emredogan7/METU-EE-2017-2018-Capstone-Design-Project-Repository/README.md

# X-Cali
The repository belonging to "X-Cali" EE493 Capstone Design Project

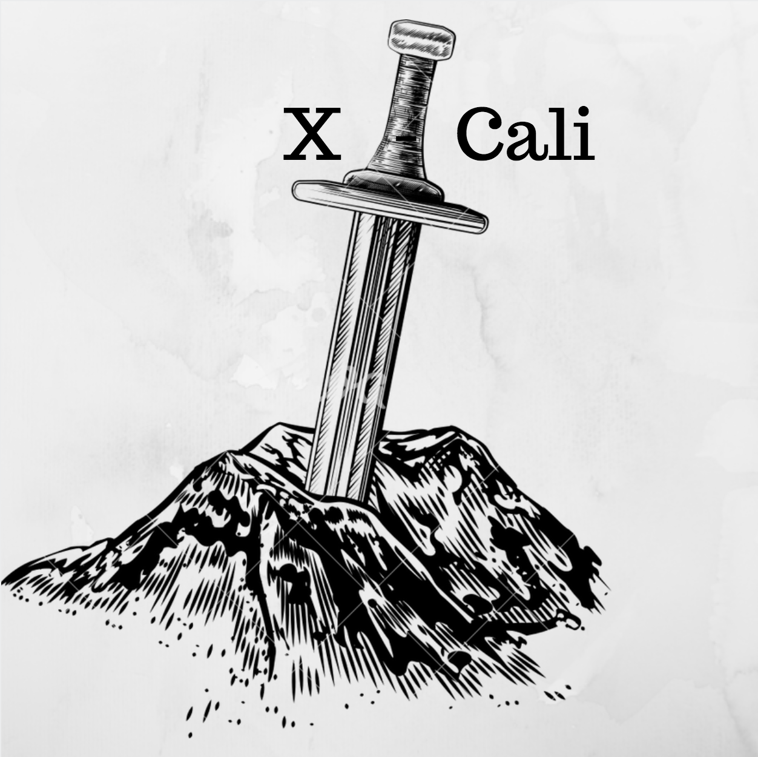
[picture p1: XCali_logo.png]


### Group Members:
- Oytun Akpulat
- Göksenin Hande Bayazıt
- Emre Doğan
- Taha Doğan
- Burak Sezgin
