emredogan7/METU-EE-2017-2018-Capstone-Design-Project-Repository/critical design/burak/Development Schedule.docx

As X-Cali, we were quite successful in our management plan despite the small breakdowns in our previous plan. Since we are halfway through and have little alterations in our plan, we saw fit to update our management plan and so our Gantt Chart. To start with, Communication Subsystem Design contents are updated to show the work to be done, more elaborately. Furthermore, Software Subsystem Design is divided into two branches as Raspberry Pi and Arduino, due to the addition of the Arduino. And their contents are updated to fit the branches, as well. Integration of Subsystems part was affected from this change and, Raspberry Pi and Arduino implementation processes is added. The rest of the management plans is kept as it used to be.

Aforementioned Future plans of X-Cali can be seen in Figure BURAYAFİGUREYAZILACAK.

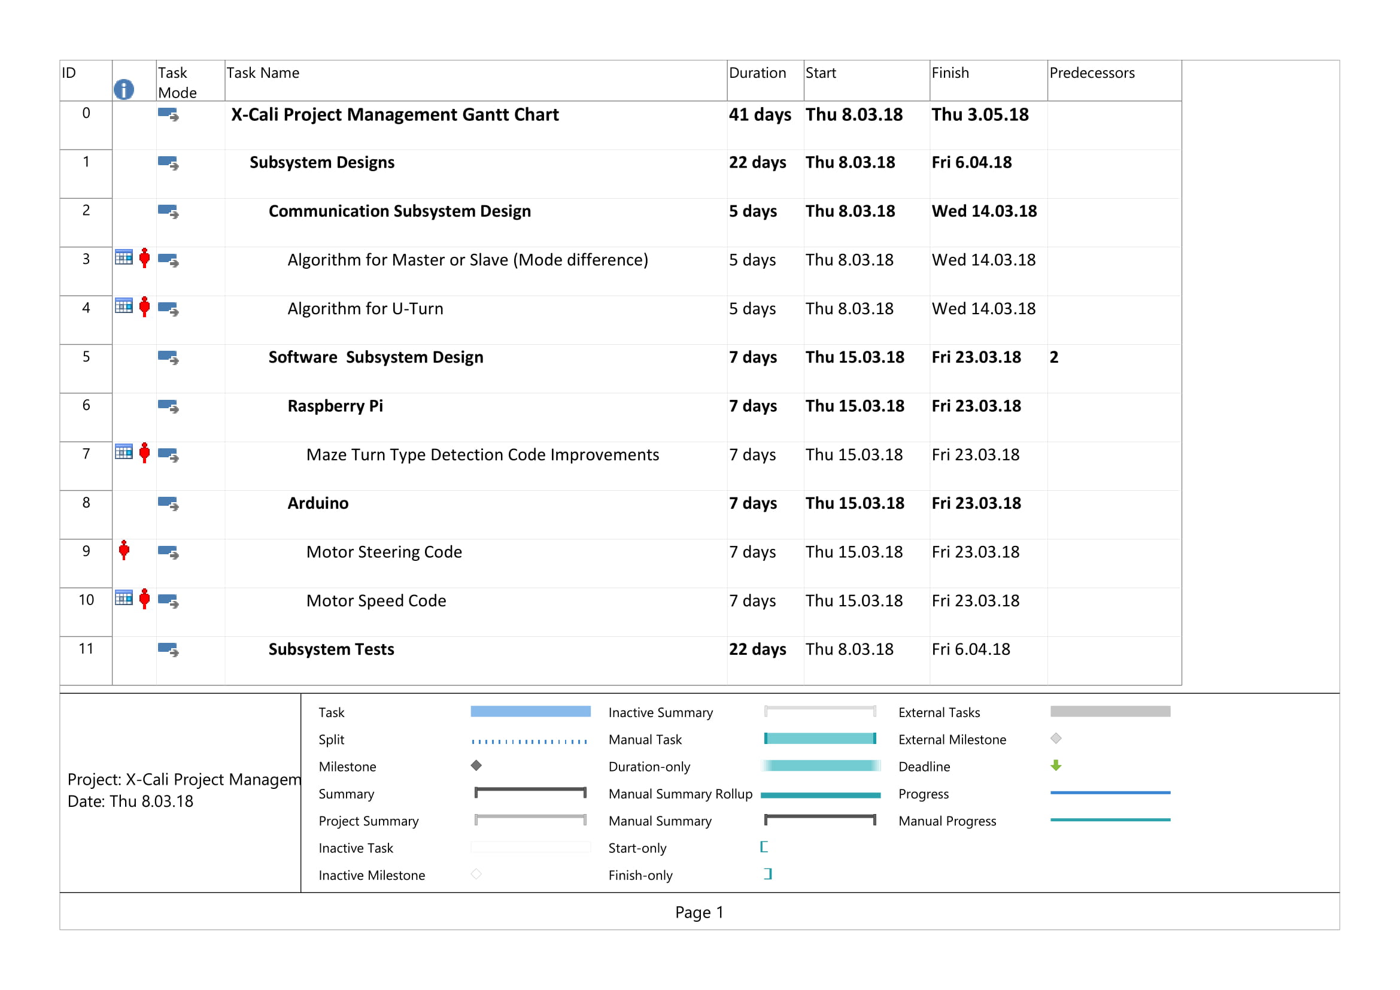
[picture p61: figure]
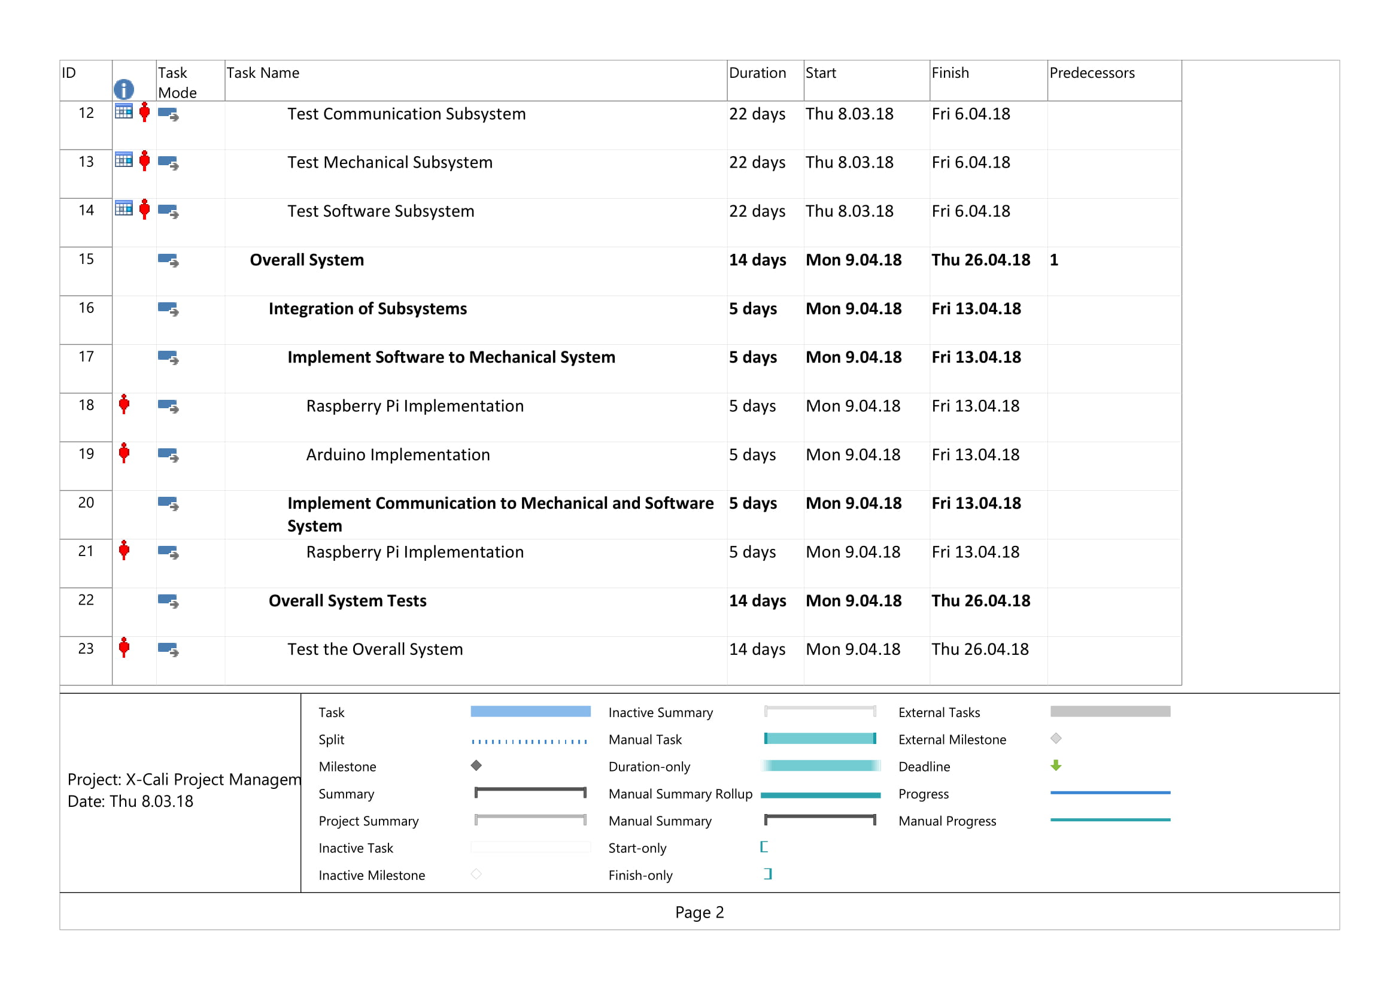
[picture p62: figure]
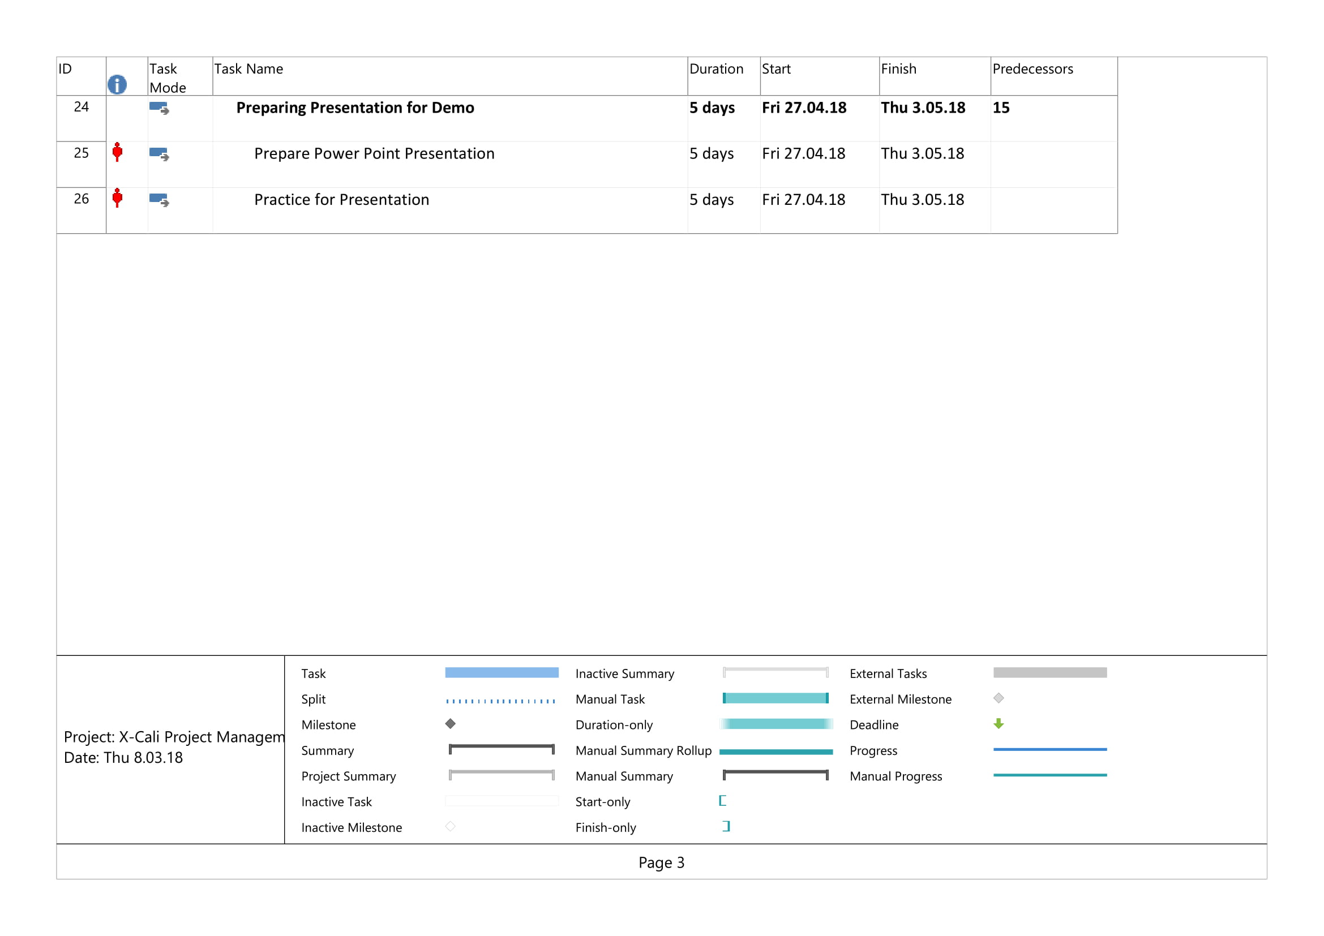
[picture p63: figure]
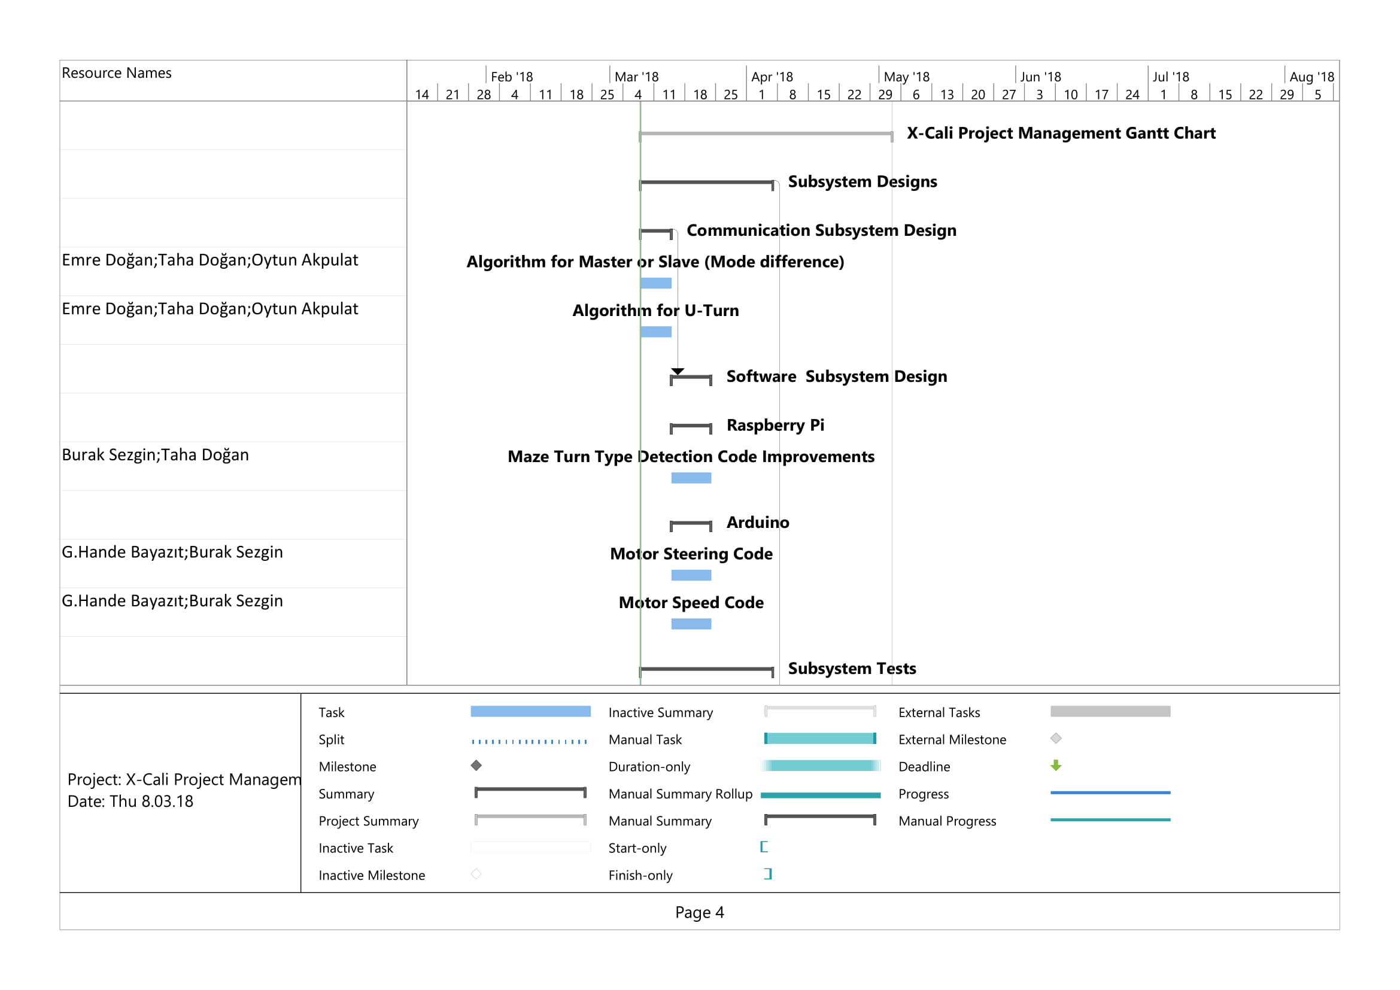
[picture p64: figure]
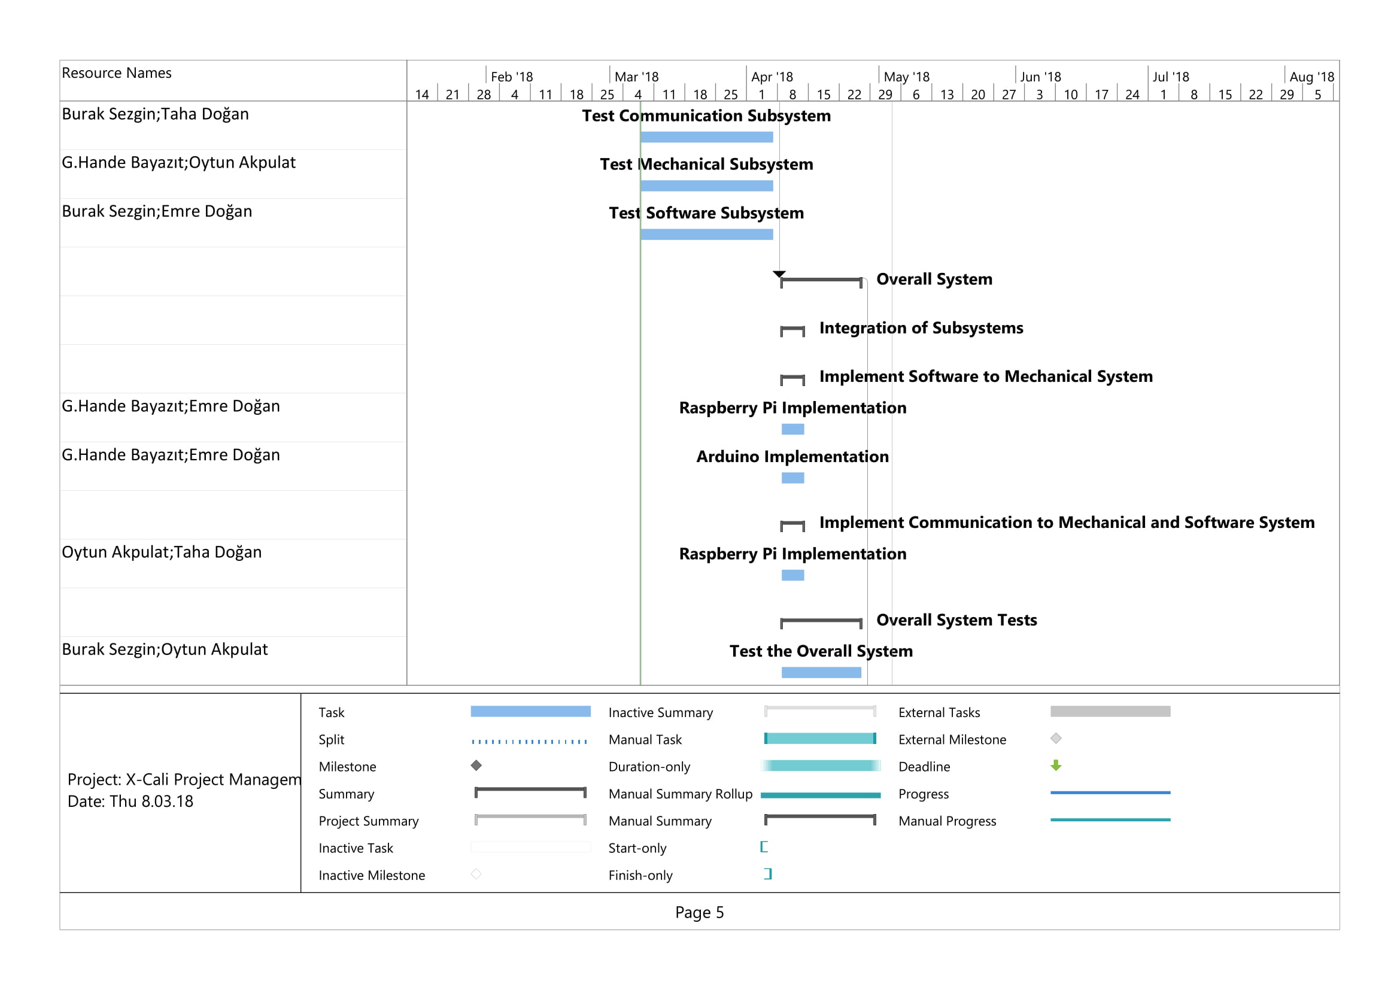
[picture p65: figure]
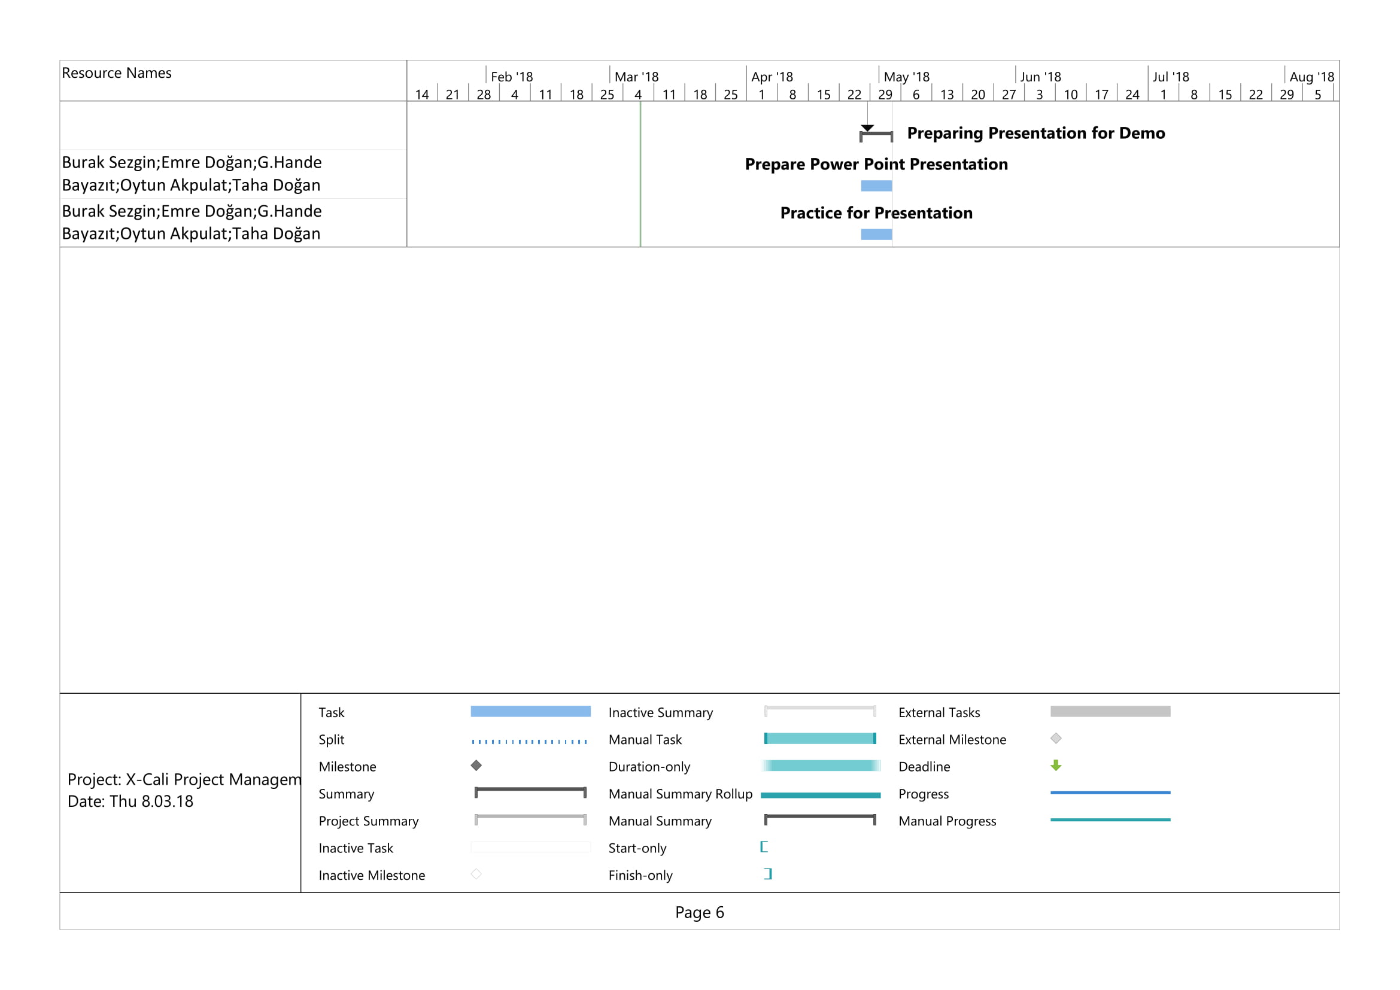
[picture p66: figure]
