emredogan7/METU-EE-2017-2018-Capstone-Design-Project-Repository/critical design/BİRLEŞMİŞİ/CDRR_X-Cali.docx

X-CALI


Critical Design Review Report

“Design of Robots Collaboratively Carrying a Long Object Through an Open-Top Maze”

Submitted to: Ali Özgür Yılmaz

Date of Submission: March 9, 2018

Company Shareholders

- Oytun Akpulat 2093201 oytun.akpulat@metu.edu.tr
- Göksenin Hande Bayazıt 2093441 hande.bayazit@metu.edu.tr
- Emre Doğan 2093656 dogan.emre@metu.edu.tr
- Taha Doğan 2093672 taha.dogan@metu.edu.tr
- Burak Sezgin 2094456 burak.sezgin@metu.edu.tr

# Introduction

# Design Description

## System Description

## Subsystem Analysis

### Body: plank, şase boyutları, pil

### Detection: kameralar, sensörler, algoritma

### Movement: tekerler motorlar, algoritma

## Component Analysis

### Microcontrollers: RP3, Arduino Uno

### Sensors: Ultrasonic, IR

### Motors:

### Chassis: wooden

### Wheels: material, plastic mad wheel: aluminum

## Requirement Analysis

## Risk Analysis

## Power Consumption Analysis

## Cost Analysis

## Development Schedule

# Modification to Conceptual Design

# Test Procedures and Test Results

# Organization Plan

X-CALI
Software Developement
Power Systems and Efficiency
Finance
Mechanical Design
R&D
Burak SEZGİN
Emre DOĞAN
Taha DOĞAN
Oytun AKPULAT
Göksenin Hande BAYAZIT
Burak SEZGİN
Emre DOĞAN
Taha DOĞAN
Burak Sezgin
Göksenin Hande BAYAZIT
Oytun AKPULAT
Taha DOĞAN
Göksenin Hande BAYAZIT

Figure XXXXXXXXX: Organizational Structure of X-Cali

# Conclusion

# References
