emredogan7/METU-EE-2017-2018-Capstone-Design-Project-Repository/sunum_/Birleştirilmiş.pptx

## X-Cali Group

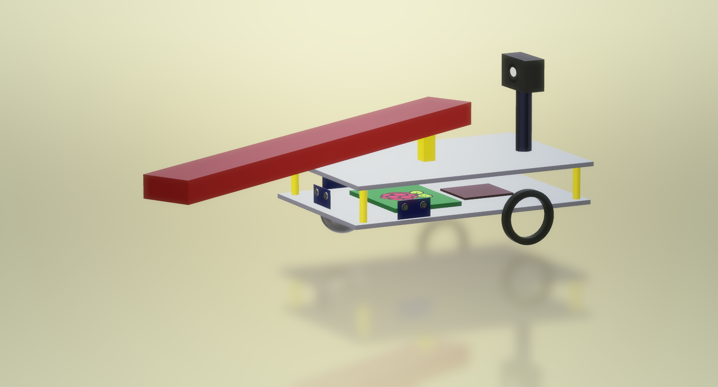
[picture p69: figure]

Burak Sezgin - 2094456
Taha Doğan - 2093672
Göksenin Hande Bayazıt - 2093441
Emre Doğan - 2093656
Oytun Akpulat - 2093201

## Slide 2

## «Robots collaboratively carrying a long object through an open-top maze»

## Outline

- Problem Statement
- Design Process & Solution Approach
- Solutions
  - Main Solution
  - Alternative Solution
- Management
- Test Plans

## Related Specifications

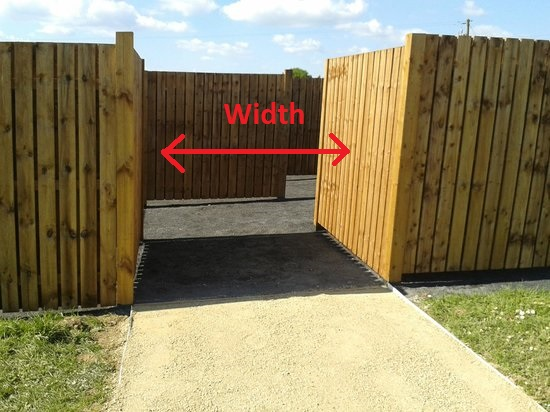
[picture p70: figure]
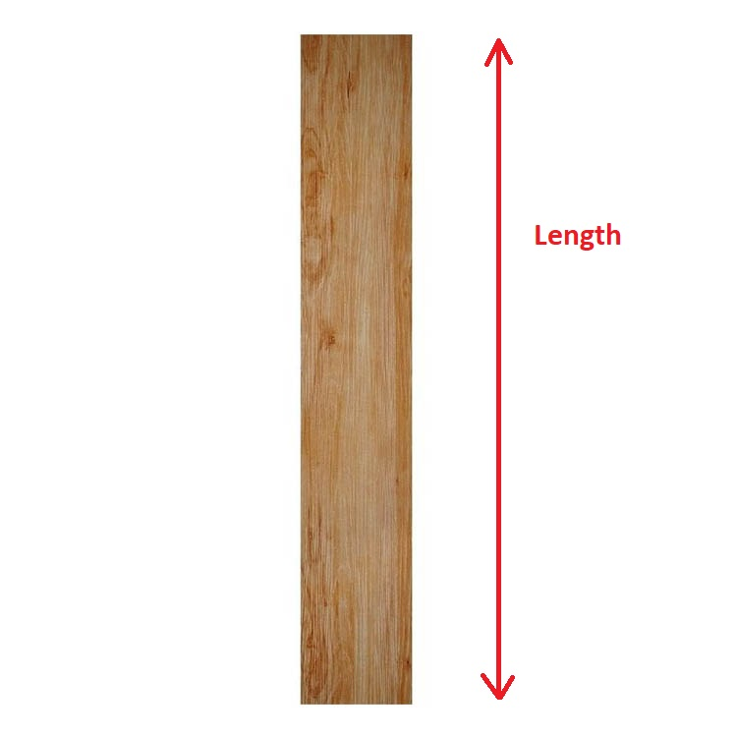
[picture p71: figure]

## Problem Statement

- Cannot make U-Turn at once

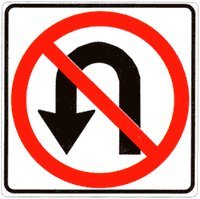
[picture p72: figure]

## Main Problem:

- Determining
- And observing the other robot

## Modes of Operation

- Master
- Slave

## Slide 9

U-Turn Example


(I)

## U-Turn Example


(II)

## U-Turn Example


(III)

## U-Turn Example


(IV)

## U-Turn Example


(V)

## Slide 14

## Design Process & Solution Approach

- Subsystems
  - Movement
    - DC Motors
    - Wheels
  - Sensors
    - Active sensors
    - Passive Sensor: Camera
  - Decision and Control
- Solution Approaches
  - Image Processing
  - Advancing Hall Effect

## Subsystems – Movement

- Motor and Wheel
  - DC motor

Normal wheel
Mad Wheel

## Subsystems – Sensors

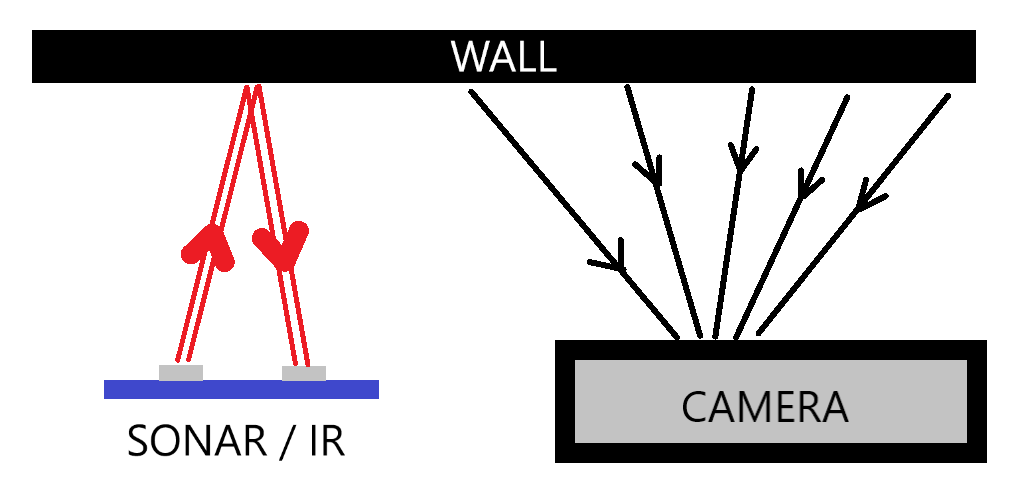
[picture p73: figure]

- Active Sensors: Proximity
  - IR sensors
  - Sonar Sensors
- Passive Sensor: Camera

## Subsystems – Decision and Control

- Microprocessor Select: RaspberryPi3
  - Fast computational skills
  - Wi-Fi Connection
  - ~~4 USB + SDCARD ports~~
  - Versatility on different applications: Image Processing
- DC Motor Driver: L298P
  - Back EMF protection
  - Easy-to-use ports
  - Frequently used, many instructive videos

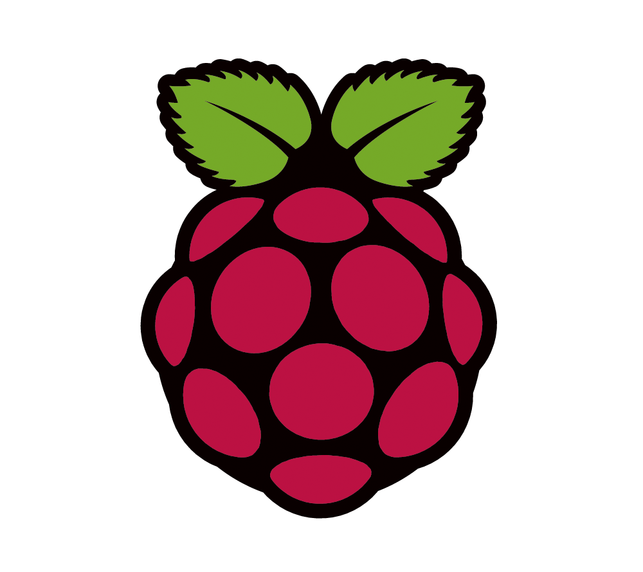
[picture p74: figure]

## Solution Approach – I: Image Processing

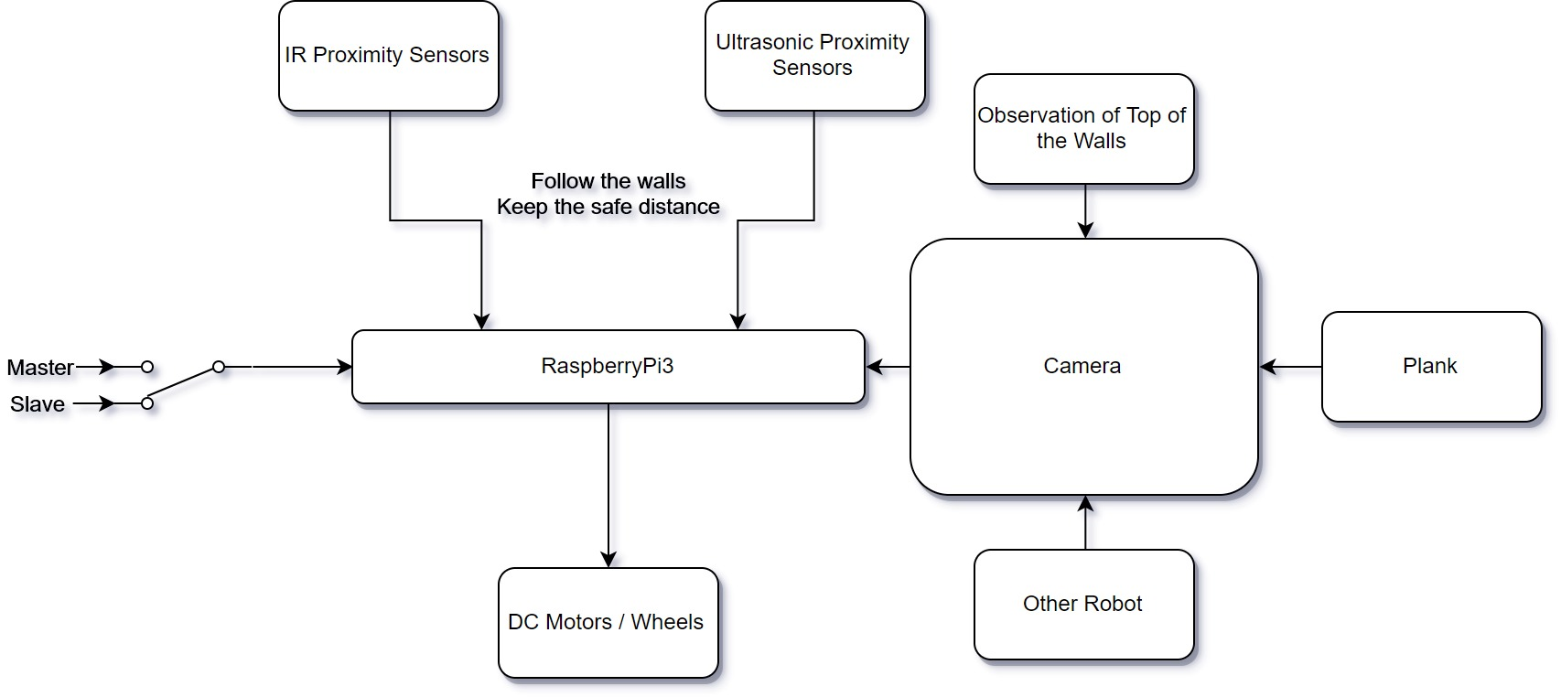
[picture p75: figure]

## Slide 20

- ~~Plank~~ ~~Detection~~
- ~~Binary~~ ~~Masking~~
- ~~Angle~~ ~~Detection~~

## Solution Approach – II: Advancing Hall Effect

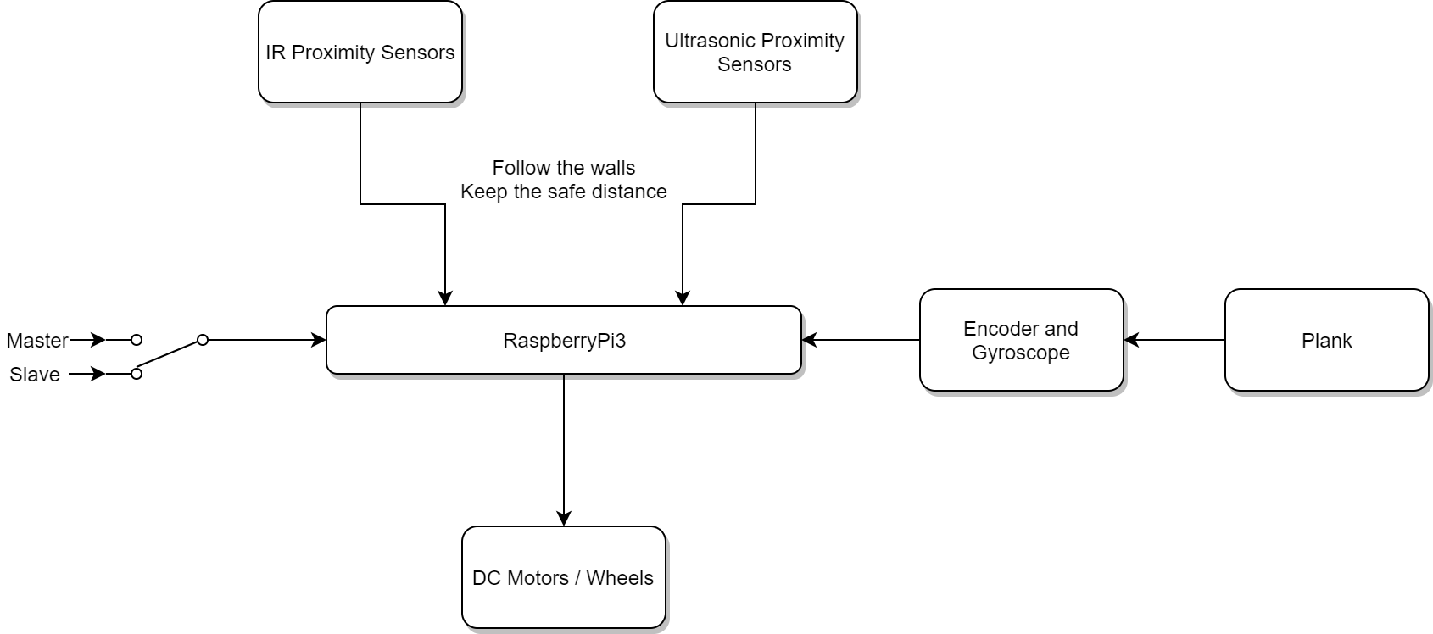
[picture p76: figure]

## Solution Approaches (Technical Details)

- Indirect communication between the robots
- Angle of holding point
  - Image processing based
  - Motion-sensing based

## Solution I: Image Processing

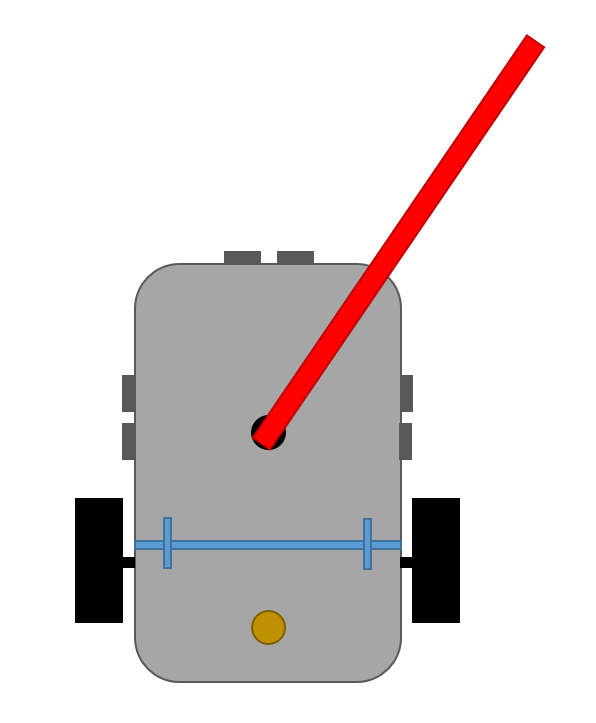
[picture p77: figure]
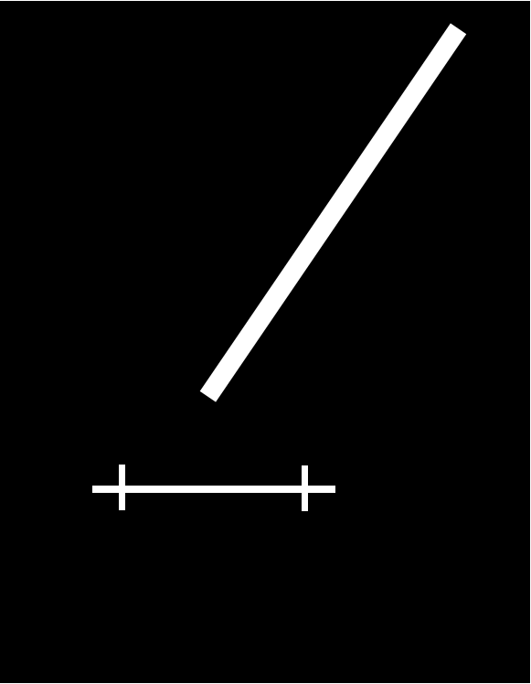
[picture p78: figure]

## Solution I: Image Processing

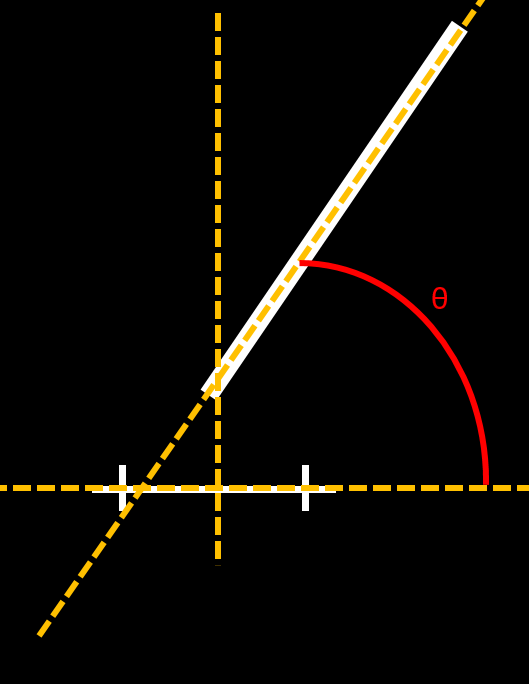
[picture p79: figure]

## Solution I: Image Processing

- Feasible
- Environment dependent
- Reliability problems

## Solution II: Motion-Sensing

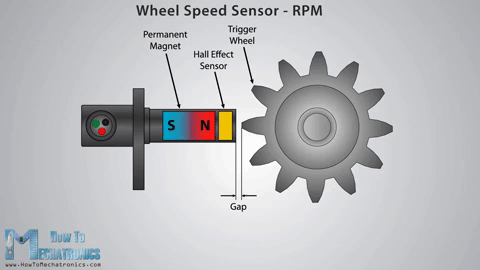
[picture p80: figure]

## Test Plans

- Integration Plans

- Conclusion

## Test Plans

- Proximity Sensor Measurements
- DC Motor Starting Current Test
- Response Time and Turning Angle Test

## Integration Plans

- Test procedure of the software design will be composed of two parts.

- Detailed Documentation of the Software
- Debugging Reports

## Conclusion

- Movement
- Sensors
- Control & Decision

## Movement

DC motor was preferred because it provides two possible speed control methods:

- PWM (Pulse Width Modulation)
- Voltage Control

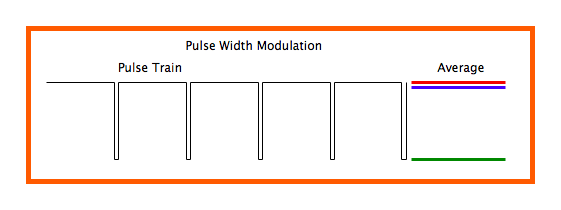
[picture p81: figure]

## Sensors

- Ultrasonic Sensor
- Infrared Sensor
- Camera

## Decision & Control

- Image processing
- Hall Effect Sensor

## Conclusion

- We hope that the X-Cali Company will be a brand new and rapidly rising brand in this market at the end of this project.
