emredogan7/METU-EE-2017-2018-Capstone-Design-Project-Repository/sunum_/Burak.pptx

## X-Cali Group

İsimler falan

## Slide 2

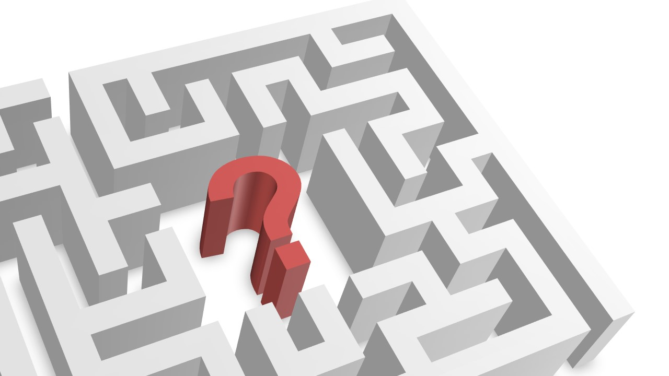
[picture p110: figure]

## Robots collaboratively carrying a long object through an open-top maze

## Outline

- Problem Statement
- Design Process & Solution Approach
- Solutions
  - Main Solution
  - Alternative Solution
- Management
- Test Plans

## Problem Statement

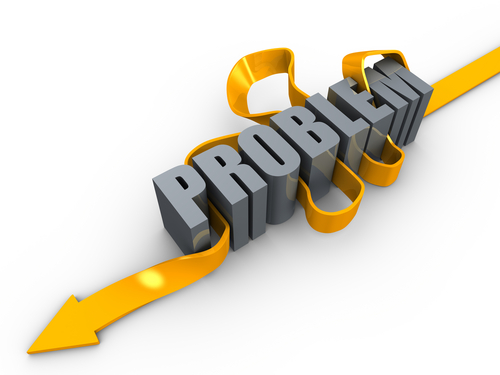
[picture p111: figure]

## Problem Statement

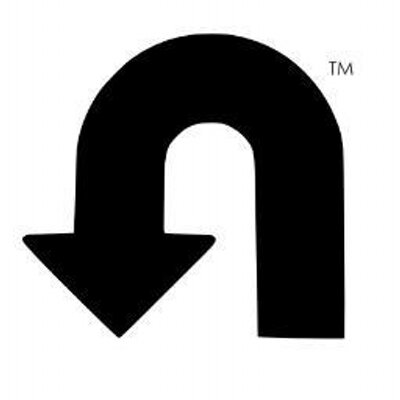
[picture p112: figure]

## Main Problem:

- Determining
- And observing the other robot

## U-Turn Example


(I)

## U-Turn Example


(II)

## U-Turn Example


(III)

## U-Turn Example


(IV)

## U-Turn Example


(V)

## No Communication!

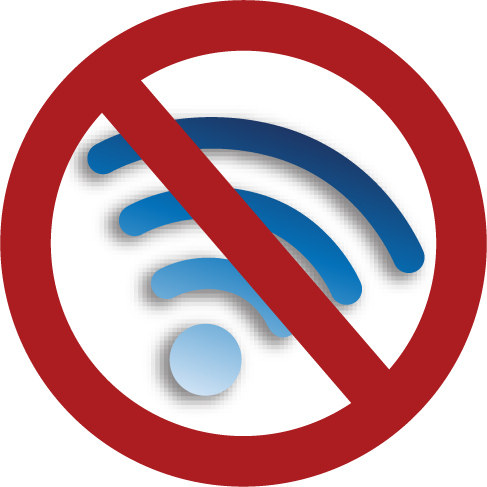
[picture p113: figure]
