emredogan7/METU-EE-2017-2018-Capstone-Design-Project-Repository/sunum_/Hande.pptx

## SOLUTION APPROACH (TECHNICAL DETAILS)

Göksenin Hande Bayazıt

## Solutions

- Image processing based
- Motion-sensing based

## Slide 3


## Slide 4


## Slide 5
