emredogan7/METU-EE-2017-2018-Capstone-Design-Project-Repository/critical design/hande/drawings/2.PNG

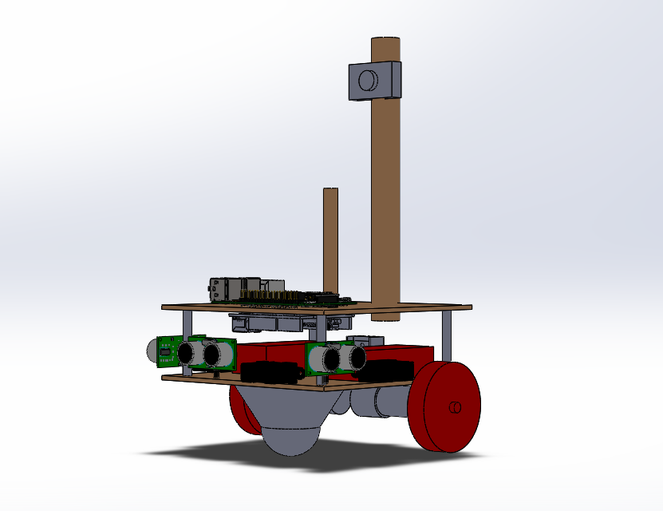
critical design/hande/drawings/2.PNG
