emredogan7/METU-EE-2017-2018-Capstone-Design-Project-Repository/critical design/hande/drawings/4.PNG

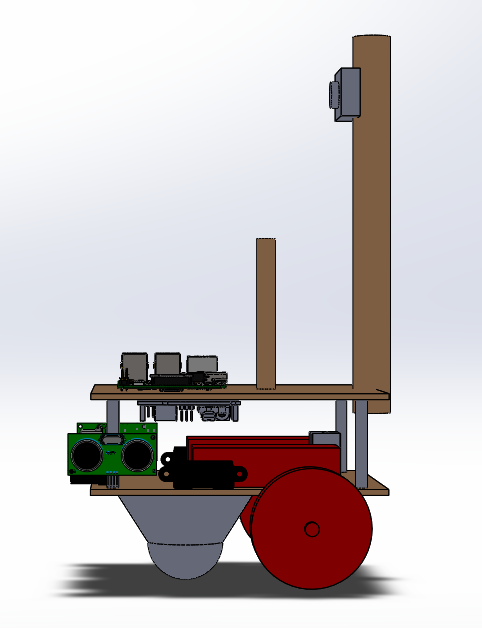
critical design/hande/drawings/4.PNG
