emredogan7/METU-EE-2017-2018-Capstone-Design-Project-Repository/Final Report/Master - Slave FSM.jpg

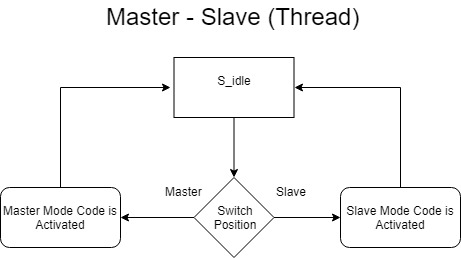
Final Report/Master - Slave FSM.jpg
