emredogan7/METU-EE-2017-2018-Capstone-Design-Project-Repository/Final Report/Maze Turn Type Indentifier FSM.jpg

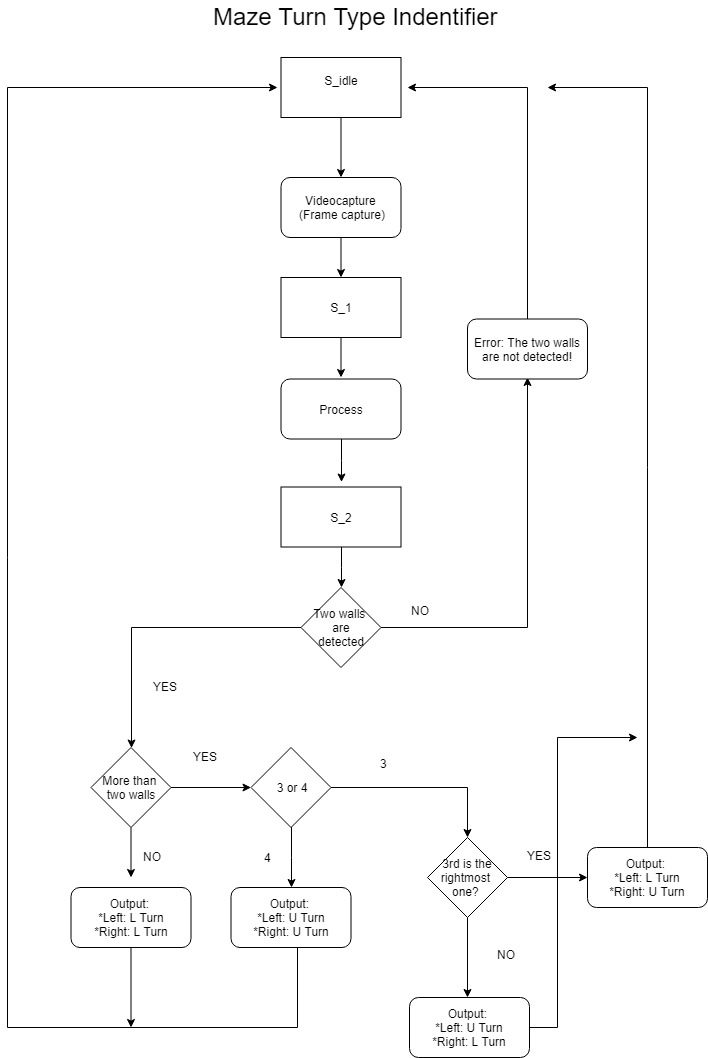
Final Report/Maze Turn Type Indentifier FSM.jpg
