emredogan7/METU-EE-2017-2018-Capstone-Design-Project-Repository/Final Report/WhatsApp Image 2018-04-14 at 11.19.52.jpeg

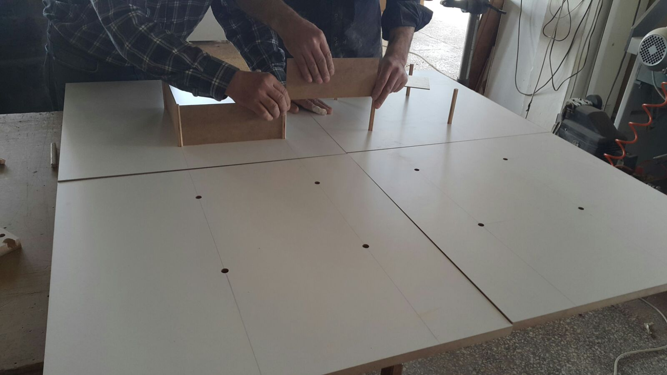
Final Report/WhatsApp Image 2018-04-14 at 11.19.52.jpeg
