emredogan7/METU-EE-2017-2018-Capstone-Design-Project-Repository/images/20180326_095948.jpg

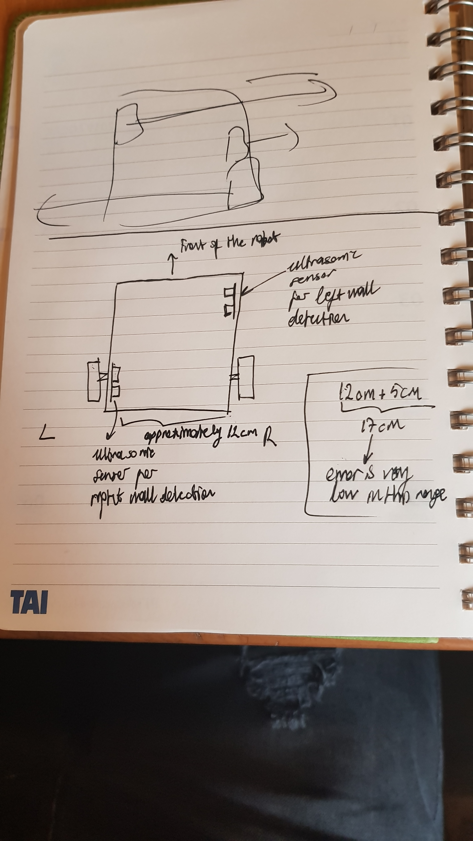
images/20180326_095948.jpg
