emredogan7/METU-EE-2017-2018-Capstone-Design-Project-Repository/images/color_detect.png

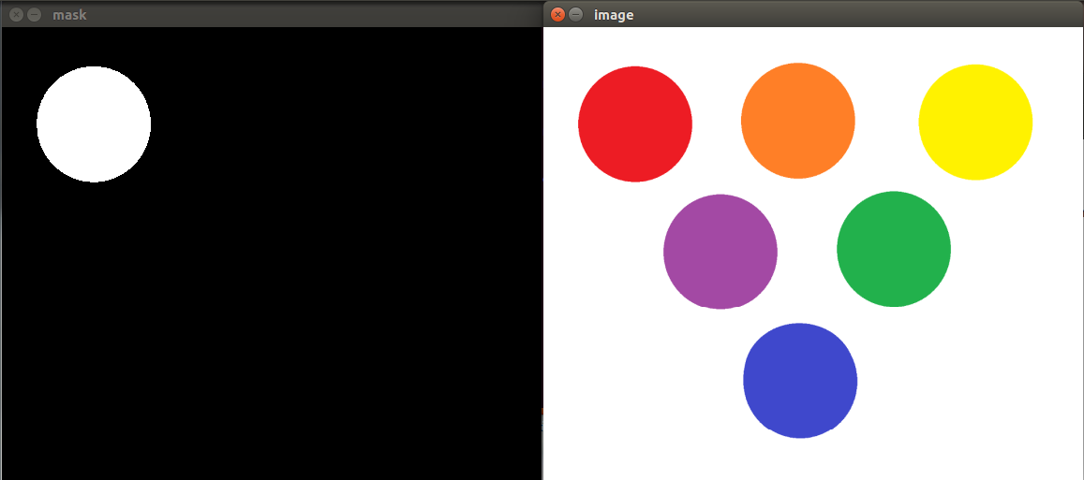
images/color_detect.png
