emredogan7/METU-EE-2017-2018-Capstone-Design-Project-Repository/images/Detecting if other robot stopped/IMG_4360.JPG

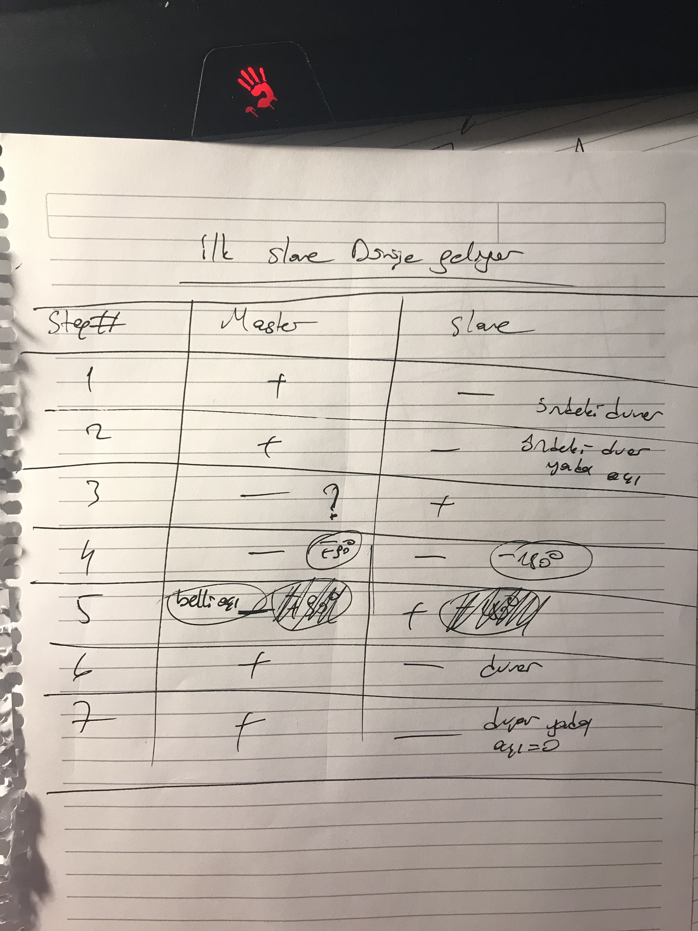
images/Detecting if other robot stopped/IMG_4360.JPG
