emredogan7/METU-EE-2017-2018-Capstone-Design-Project-Repository/images/edge_detection.jpg

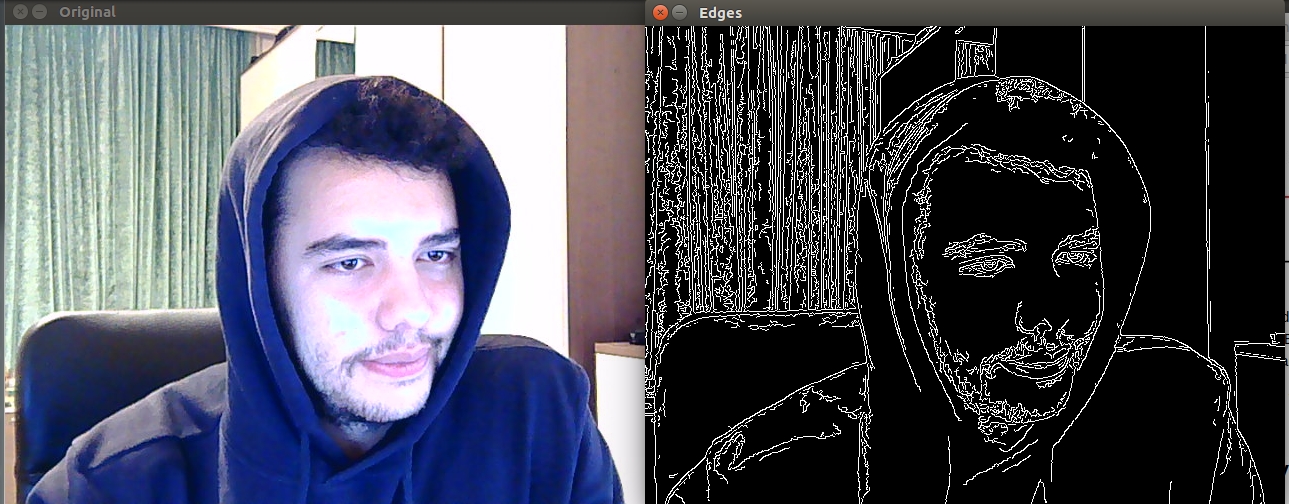
images/edge_detection.jpg
