emredogan7/METU-EE-2017-2018-Capstone-Design-Project-Repository/images/turn_algo/Burak/IMG_4321.JPG

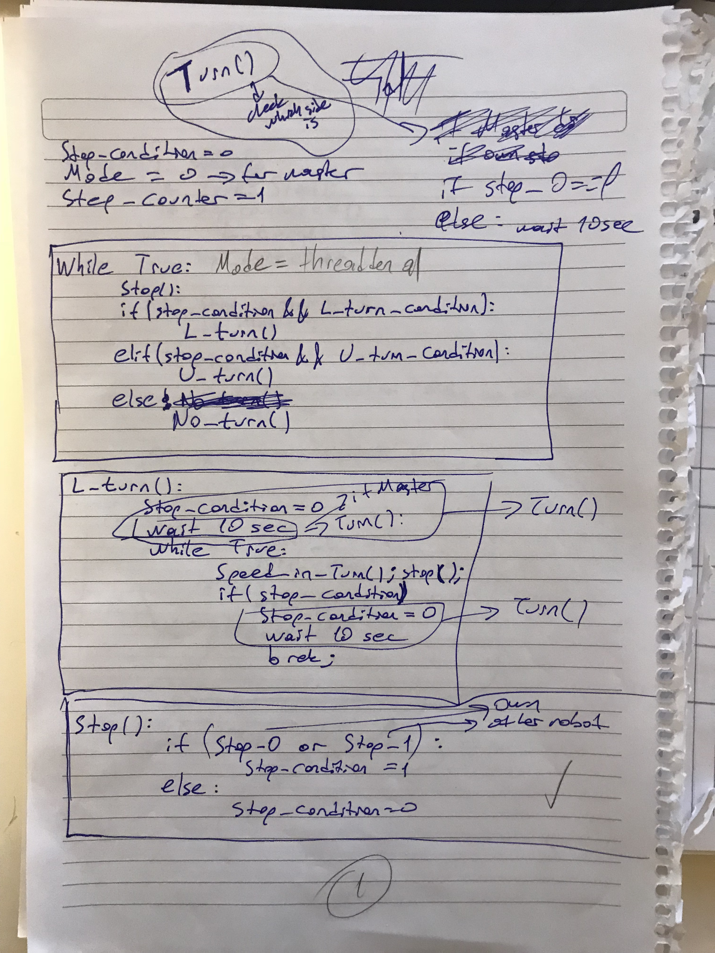
images/turn_algo/Burak/IMG_4321.JPG
