emredogan7/METU-EE-2017-2018-Capstone-Design-Project-Repository/images/turn_algo/Burak/IMG_4323.JPG

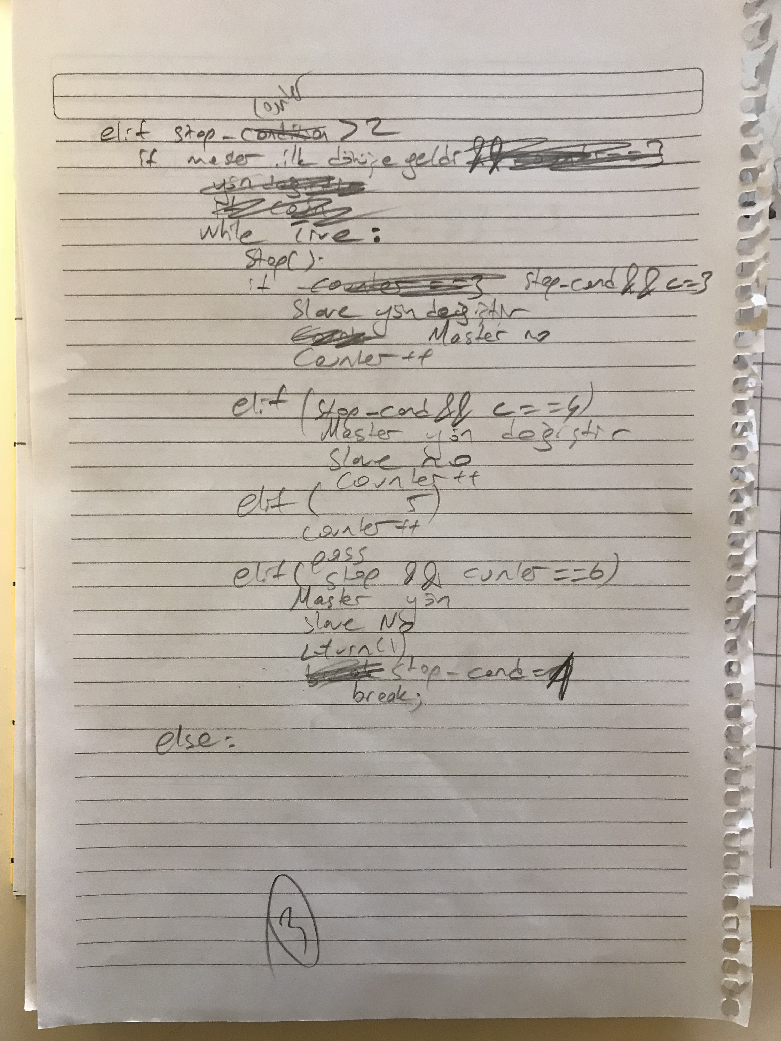
images/turn_algo/Burak/IMG_4323.JPG
