emredogan7/METU-EE-2017-2018-Capstone-Design-Project-Repository/images/turn_algo/Taha - Burak/IMG_4319.JPG

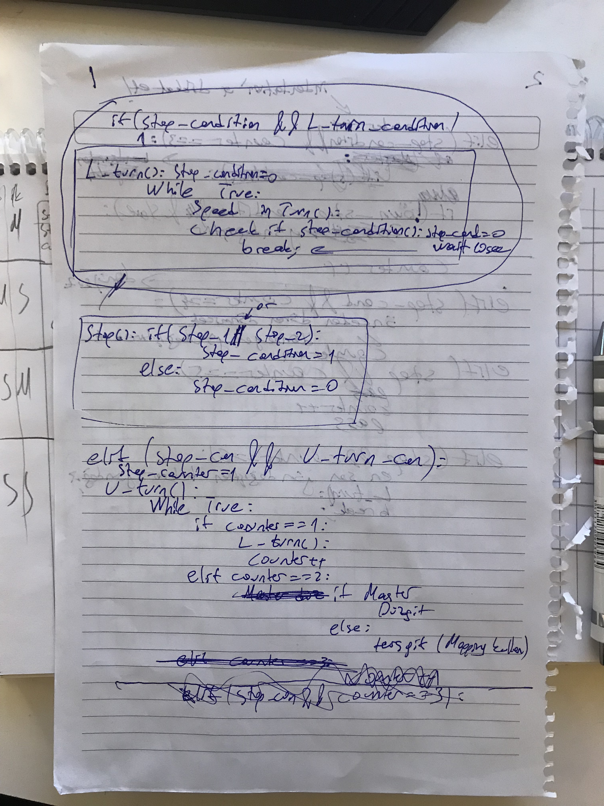
images/turn_algo/Taha - Burak/IMG_4319.JPG
