emredogan7/METU-EE-2017-2018-Capstone-Design-Project-Repository/images/turn_algo_code.JPG

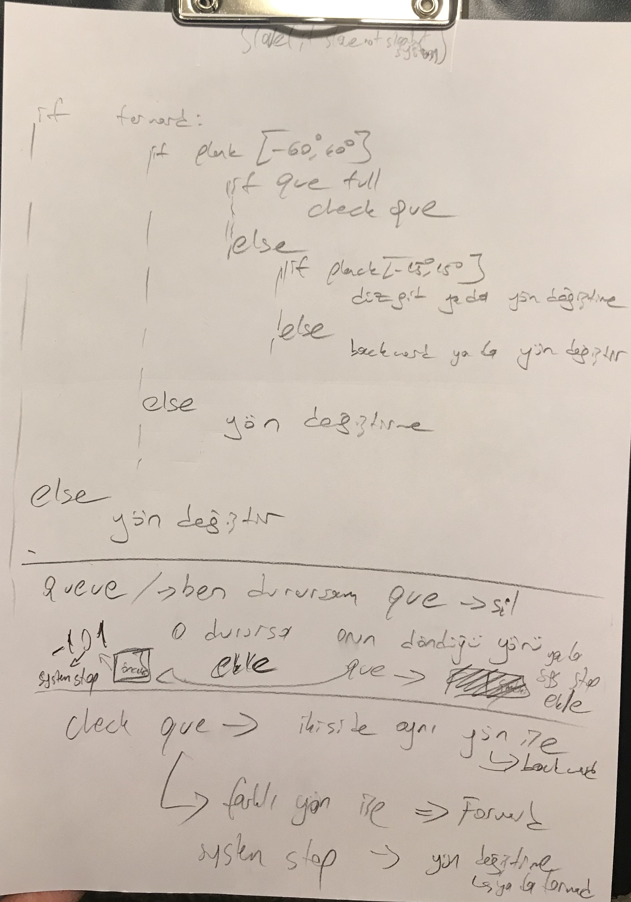
images/turn_algo_code.JPG
