emredogan7/METU-EE-2017-2018-Capstone-Design-Project-Repository/Poster/WhatsApp Image 2018-05-17 at 15.54.25.jpeg

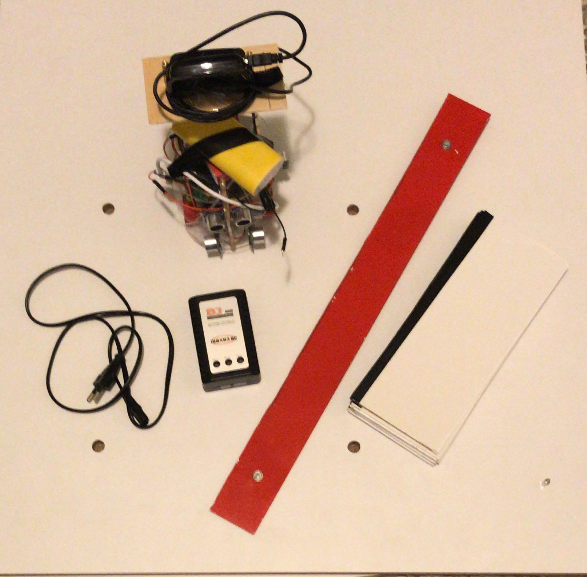
Poster/WhatsApp Image 2018-05-17 at 15.54.25.jpeg
