emredogan7/METU-EE-2017-2018-Capstone-Design-Project-Repository/Presentation/123 (2).PNG

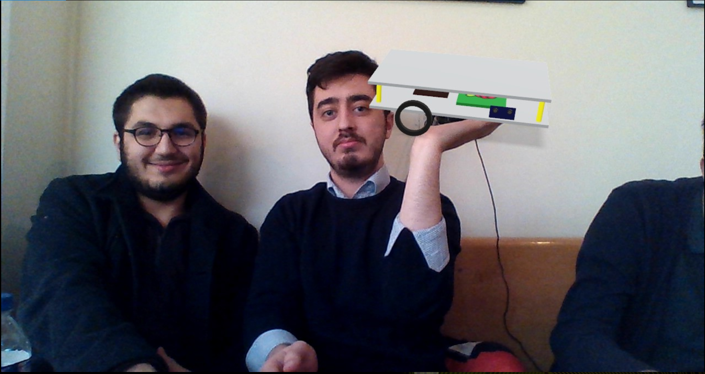
Presentation/123 (2).PNG
