emredogan7/METU-EE-2017-2018-Capstone-Design-Project-Repository/Presentation/EE493 Sunum/active passive.png

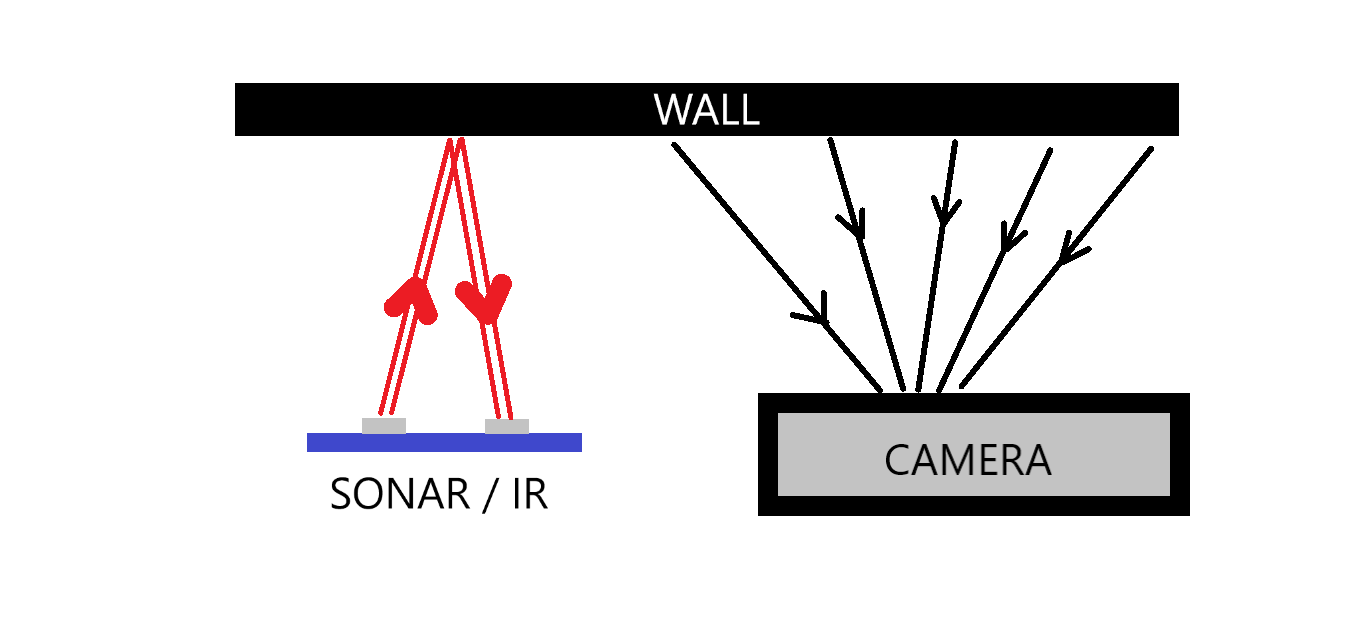
Presentation/EE493 Sunum/active passive.png
