emredogan7/METU-EE-2017-2018-Capstone-Design-Project-Repository/Presentation/ekran görüntüsü.png

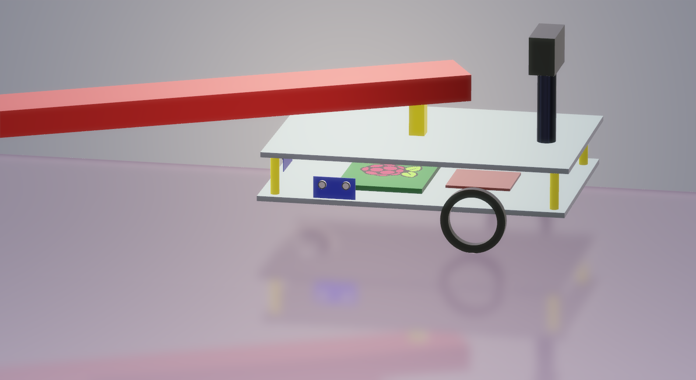
Presentation/ekran görüntüsü.png
