emredogan7/METU-EE-2017-2018-Capstone-Design-Project-Repository/PWM_2_DC.png

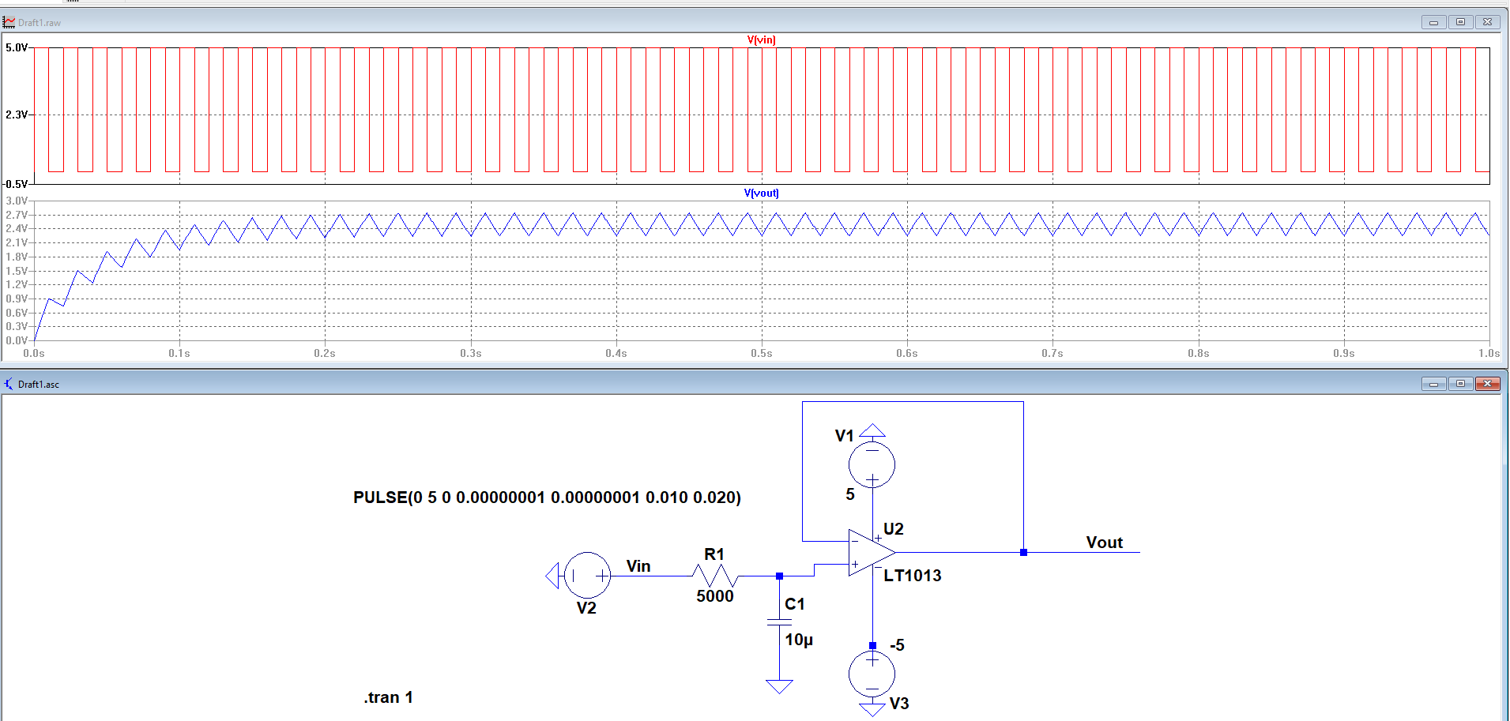
PWM_2_DC.png
