emredogan7/METU-EE-2017-2018-Capstone-Design-Project-Repository/Reference/gpio-descriptions.png

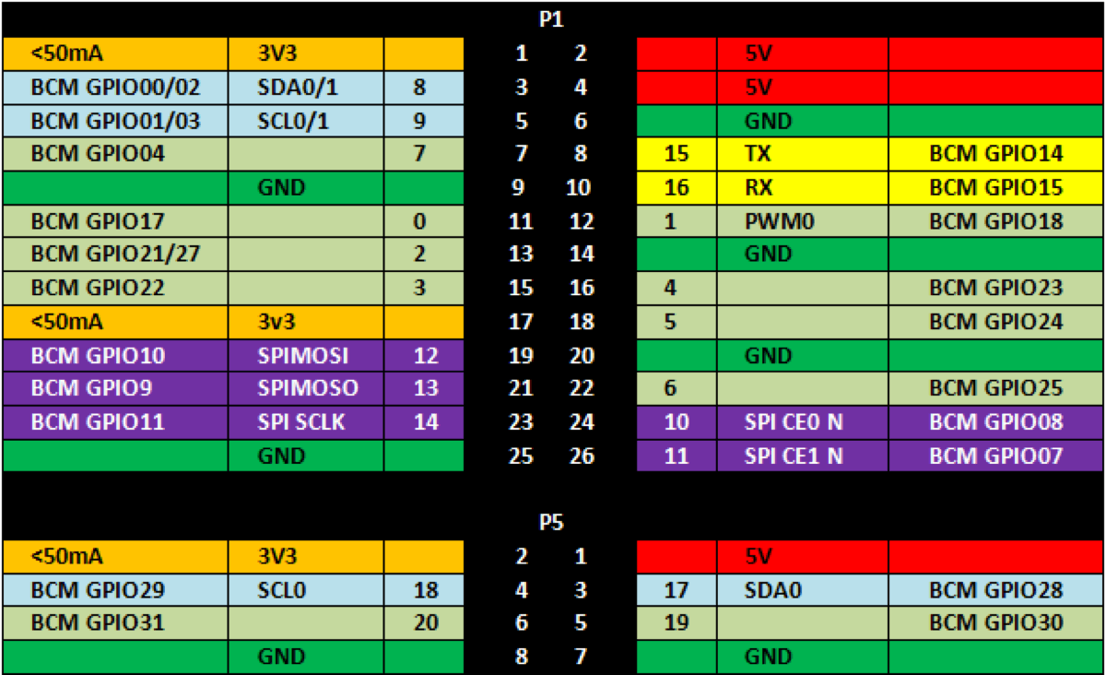
Reference/gpio-descriptions.png
