emredogan7/METU-EE-2017-2018-Capstone-Design-Project-Repository/Reports/Tabble.JPG

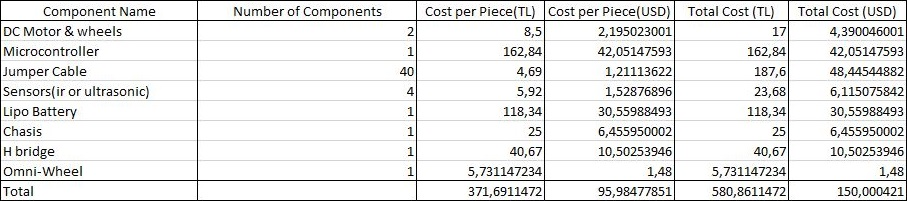
Reports/Tabble.JPG
