emredogan7/METU-EE-2017-2018-Capstone-Design-Project-Repository/Reports/tabble.xlsx

Component Name | Number of Components | Cost per Piece(TL) | Cost per Piece(USD) | Total Cost (TL) | Total Cost (USD)
DC Motor & wheels | 2 | 8.5 | 2.195023001 | 17 | 4.390046001
Microcontroller | 1 | 162.84 | 42.05147593 | 162.84 | 42.05147593
Jumper Cable | 40 | 4.69 | 1.21113622 | 187.6 | 48.44544882
Sensors(ir or ultrasonic) | 4 | 5.92 | 1.52876896 | 23.68 | 6.115075842
Lipo Battery | 1 | 118.34 | 30.55988493 | 118.34 | 30.55988493
Chasis | 1 | 25 | 6.455950002 | 25 | 6.455950002
H bridge | 1 | 40.67 | 10.50253946 | 40.67 | 10.50253946
Omni-Wheel | 1 | 5.731147234 | 1.48 | 5.731147234 | 1.48
Total |  | 371.6911472 | 95.98477851 | 580.8611472 | 150.000421
