emredogan7/METU-EE-2017-2018-Capstone-Design-Project-Repository/Tests/motor-test-word.docx

DC Motor Starting Current Test

by Go¨ksenin Hande Bayazıt & Taha Dog˘an

Dec. 17, 2017

# 1 Test Conditions

- Location: Design Studio
- Date: Dec. 17, 2017
- Ambient Temperature: Room temperature (appx. 23-25◦C)
- Environment: Loud, luminous

# 2 Test Procedure

The aim of this test is to measure the starting current of the DC motor. To achieve this, a microcontroller is programmed as a digital voltmeter (in the scope of EE447 laboratory). With such a setup, the voltage drop on a resistor connected in series to the terminals of the motor can be measured and recorded, which provides the information of armature current of the motor.

However, as the resistance value of the measurement resistor is not negligible compared to the internal resistance of the motor, it causes a significant change in the starting current. For that reason, internal resistance of the DC motor should be determined with full-load test in order to be able to make necessary calculations. (In full-load test, starting current of the DC motor is measured when the shaft speed, hence the back EMF is 0. Therefore, having the terminal voltage and armature current informations, we are able to determine the value of internal resistance.)

# 3 Test Results

## 3.1 Full-Load Test

3.1.1 Specifications:

- Battery Voltage Before Measurement: 8.1 V
- Battery Voltage After Measurement: 8 V
- ω = 0 rad/s, Eb = 0 V

3.1.2 Measurement Results:

1. Ia = 0.60 A
2. Ia = 0.58 A
3. Ia = 0.55 A
4. Ia = 0.56 A
5. Ia = 0.61 A
6. Ia = 0.55 A
7. Ia = 0.55 A
8. Ia = 0.56 A
9. Ia = 0.54 A
10. Ia = 0.55 A

Mean: Ia = 0.57 A

## 3.2 Starting Current

3.2.1 Specifications:

- Measurement Resistor: 10 Ω
- Battery Voltage: 8 V
- Mechanical Load: Tyre moving on low-friction-surface

3.2.2 Measurement Results:

1. Ia = 0.067 A
2. Ia = 0.064 A
3. Ia = 0.065 A
4. Ia = 0.066 A
5. Ia = 0.062 A
6. Ia = 0.065 A
7. Ia = 0.067 A
8. Ia = 0.065 A
9. Ia = 0.065 A
10. Ia = 0.064 A

Mean: Ia = 0.065 A

Approximate Calculated Starting Current:

Starting Current Measured with Multimeter: 0.13 A

# 4 Conclusion

These tests are performed in order to observe and measure the current rating of the motors at worst case (i.e. at start and at full-load). Considering the test results, it can be concluded that the amount current drawn by motors is far from being harmful for the battery, the motor drive and the rest of the system.
