emredogan7/METU-EE-2017-2018-Capstone-Design-Project-Repository/Tests/test.docx

0.02V

0.00V

0.02V

0.00V

0.02V

0.00V

0.02V

0.00V

0.02V

0.00V

0.05V

0.64V

0.62V

0.53V

0.49V

0.43V

0.38V

0.28V

0.33V

0.28V

0.35V

0.26V

0.28V

0.23V

0.27V

0.23V

0.19V

0.23V

0.25V

0.23V

0.21V

0.23V

0.21V

0.17V

0.15V

0.24V

0.15V

0.17V

0.14V

0.18V

0.12V

0.20V

0.00V

0.15V

0.12V

0.10V

0.13V

0.16V

0.02V

0.15V

0.09V

0.02V

0.14V

0.18V

0.11V

0.13V

0.17V

0.19V

0.02V

0.00V

0.12V

0.20V

0.15V

0.09V

0.13V

0.10V

0.14V

0.05V

0.11V

0.17V

0.13V

0.10V

0.12V

0.59V

0.09V

0.14V

0.19V

0.12V

0.14V

0.02V

0.12V

0.16V

0.12V

0.16V

0.11V

0.06V

0.00V

0.12V

0.15V

0.13V

0.15V

0.18V

0.07V

0.10V

0.12V

0.01V

0.10V

0.17V

0.12V

0.18V

0.15V

0.11V

0.02V

0.12V

0.00V

0.13V

0.16V

0.14V

0.18V

0.13V

0.06V

0.10V

0.12V

0.10V

0.12V

0.01V

0.12V

0.16V

0.12V

0.18V

0.16V

0.09V

0.07V

0.09V

0.07V

0.12V

0.10V

0.00V

0.02V

0.10V

0.15V

0.12V

0.00V

0.02V

0.00V

0.02V

0.00V

0.02V

0.00V

0.02V

0.00V

0.02V

0.00V

0.02V

0.00V

0.02V

0.00V

0.02V

0.00V

0.02V

0.00V

0.03V

0.66V

0.58V

0.55V

0.46V

0.48V

0.42V

0.39V

0.37V

0.31V

0.33V

0.26V

0.23V

0.25V

0.23V

0.17V

0.26V

0.21V

0.23V

0.15V

0.21V

0.19V

0.04V

0.08V

0.17V

0.13V

0.20V

0.10V

0.15V

0.00V

0.16V

0.13V

0.00V

0.16V

0.18V

0.07V

0.15V

0.12V

0.01V

0.03V

0.10V

0.18V

0.06V

0.12V

0.17V

0.20V

0.14V

0.10V

0.00V

0.16V

0.18V

0.15V

0.09V

0.13V

0.15V

0.06V

0.12V

0.01V

0.03V

0.10V

0.13V

0.11V

0.14V

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

0.15V

0.08V

0.10V

0.08V

0.10V

0.00V

0.10V

0.14V

0.11V

0.00V

0.02V

0.14V

0.17V

0.00V

0.02V

0.00V

0.02V

0.00V

0.02V

0.00V

0.02V

0.00V

0.02V

0.00V

0.02V

0.00V

0.02V

0.00V

0.02V

0.00V

0.02V

0.00V

0.02V

0.00V

0.02V

0.00V

0.02V

0.00V

0.02V

0.00V

0.02V

0.00V
