emredogan7/METU-EE-2017-2018-Capstone-Design-Project-Repository/Code/run_motor.py

import sys
import time
import RPi.GPIO as GPIO

mode=GPIO.getmode()

GPIO.cleanup()

FwdL=26
BwdL=20
FwdR=19
BwdR=16
sleeptime=1

GPIO.setmode(GPIO.BCM)
GPIO.setup(FwdL, GPIO.OUT)
GPIO.setup(FwdR, GPIO.OUT)
GPIO.setup(BwdL, GPIO.OUT)
GPIO.setup(BwdR, GPIO.OUT)

def forward(x):
    GPIO.output(FwdL, GPIO.HIGH)
    GPIO.output(FwdR, GPIO.HIGH)
    print("Moving Forward")
    time.sleep(x)
    GPIO.output(FwdL, GPIO.LOW)
    GPIO.output(FwdR, GPIO.LOW)

def reverse(x):
    GPIO.output(BwdL, GPIO.HIGH)
    GPIO.output(BwdR, GPIO.HIGH)
    print("Moving Backward")
    time.sleep(x)
    GPIO.output(BwdL, GPIO.LOW)
    GPIO.output(BwdR, GPIO.LOW)


while (1):
    
    forward(5)

    reverse(5)
GPIO.cleanup()
