emredogan7/METU-EE-2017-2018-Capstone-Design-Project-Repository/Code/edge_detection_canny.py

import numpy as np
import argparse
import cv2
 
cap = cv2.VideoCapture(0)
 
while(1):
  ret, frame = cap.read()
  gray_vid = cv2.cvtColor(frame, cv2.IMREAD_GRAYSCALE)
  cv2.imshow('Original',frame)
  edged_frame = cv2.Canny(frame,100,200)
  cv2.imshow('Edges',edged_frame)
  if cv2.waitKey(1) & 0xFF == ord('q'):
        break
cap.release()
cv2.destroyAllWindows()
