emredogan7/METU-EE-2017-2018-Capstone-Design-Project-Repository/(commit log)

2017-10-15 Örnek notlandırma tablosu
    İsterseniz değiştirebiliriz. Hatta direk kullanmayabiliriz bile ama fikir vermesi için denenebilir. Siz de bir bakın olmadı yüzyüze tartışırız.
    [Proje Notlandırma.xlsx]
2017-10-17 cvler eklendi, oytununki de eklendi
2017-11-09 bu da değiştirmek isterseniz diye gençler
    [tabble.xlsx]
2017-12-02 Prox. sensor Manual
2017-12-02 Prox. Sensor Meas.
    [Proximity Sensor Measurements.xlsx]
2017-12-13 running code
    motoru döndürüyor :yay:
2017-12-13 çift motor
2017-12-14 folder update
    [Proje Notlandırma.xlsx, Proximity Sensor Measurements.xlsx, tabble.xlsx]
2017-12-17 sensor output and motor drive integrated
    engel yoksa ileri engel varsa geri gidiyor
2017-12-17 edit (pin assignment)
2017-12-17 report of the motor test
2017-12-28 algorithm de düzenleme
2018-02-21 motor pid control with arduino
2018-03-02 Master or Slave with led
2018-03-02 mode indicator with switch and led
2018-03-09 power analysis and minor changes
2018-03-09 Instructions of Raspberry remote connection types
2018-03-23 Thread files
2018-04-07 motor deneme
2018-04-07 analog pin assignment
2018-04-15 arduino encoder code
2018-04-15 arduino encoder code 2
2018-04-15 arduino encoder 3
